Nebulea-dev/FlashDrink/assets/automate_etats.png

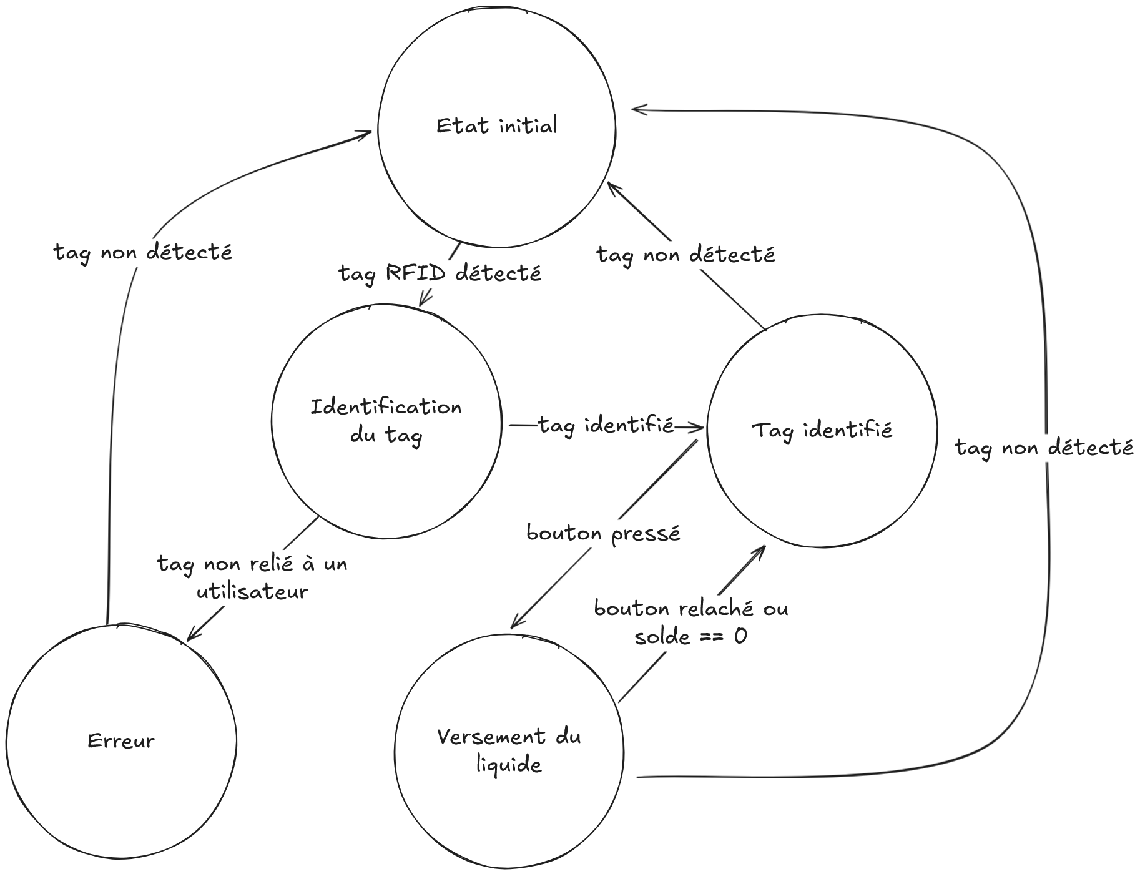
assets/automate_etats.png
