Nebulea-dev/FlashDrink/assets/branchements.png

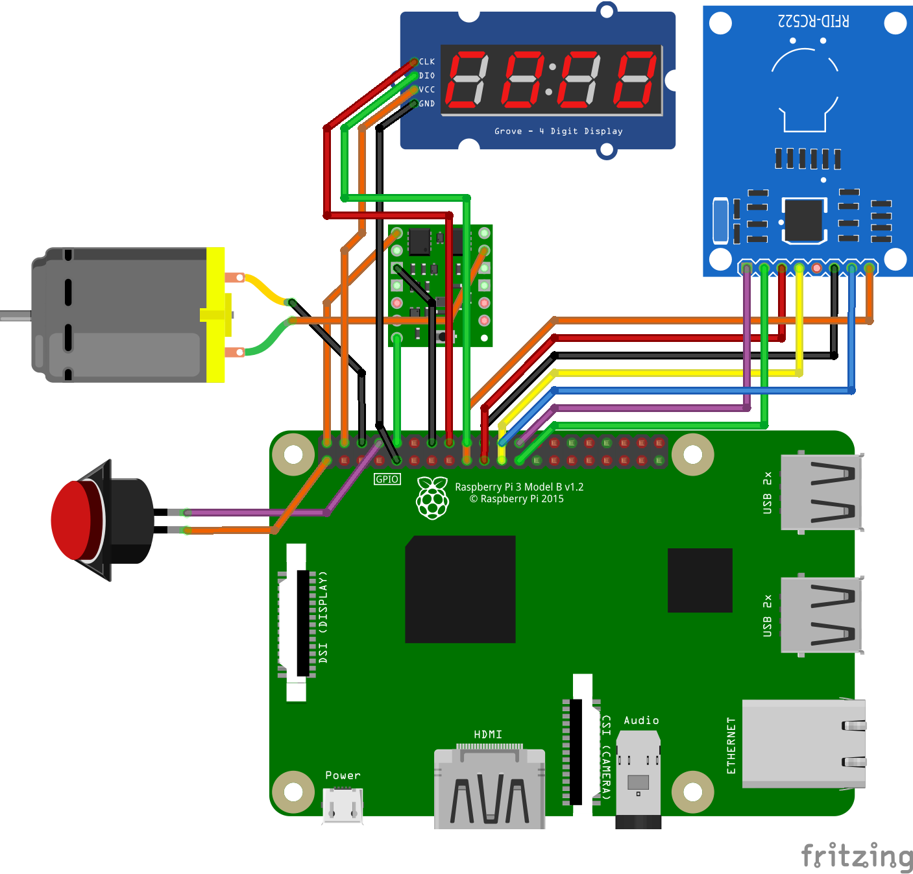
assets/branchements.png
