Nebulea-dev/FlashDrink/assets/vue_ensemble.png

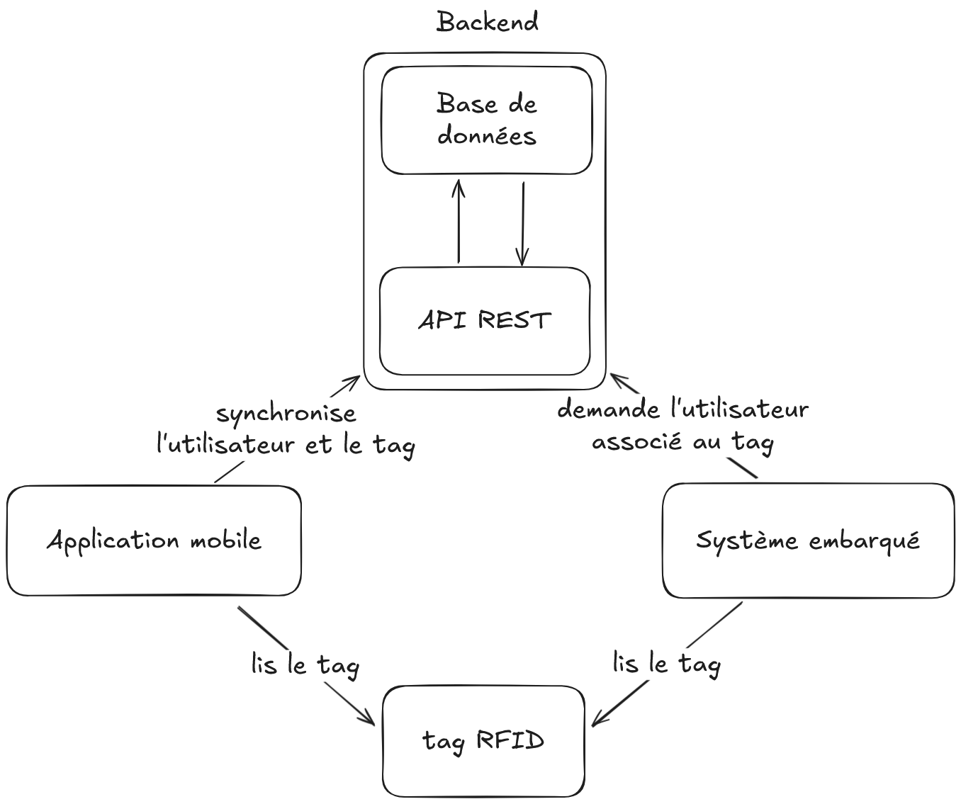
assets/vue_ensemble.png
