Nebulea-dev/FlashDrink/3D-model/flashdrink.stl

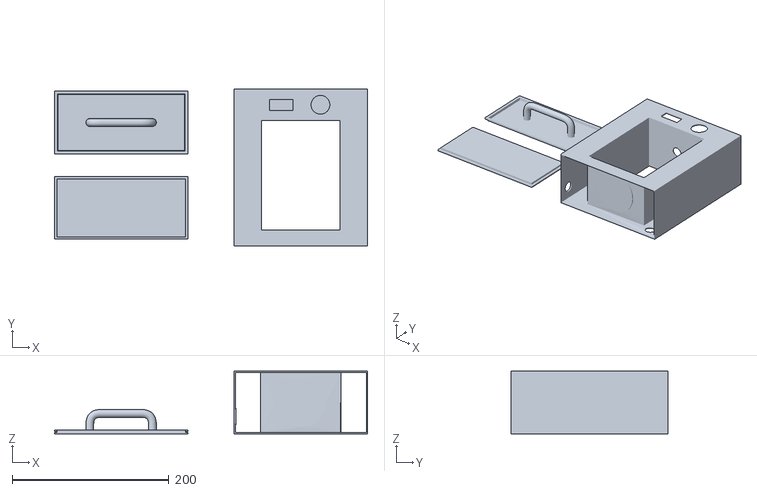
[picture p4: CAD file, 2025-01-14]
3D-model/flashdrink.stl
399.3 x 200.0 x 80.0
