Nebulea-dev/FlashDrink/(list of files, cad)

Other CAD files:
3D-model/flashdrink.blend
