Nebulea-dev/FlashDrink/raspberry/Display.py

import tm1637
class FD_Display:
    tm = tm1637.TM1637(clk=23, dio=24)

    @staticmethod
    def write_number(num: int) -> None:
        FD_Display.tm.number(num)

    @staticmethod
    def write_letters(letters) -> None:
        FD_Display.tm.show(letters)


# all LEDS on "88:88"
#tm.write([127, 255, 127, 127])

# all LEDS off
#tm.write([0, 0, 0, 0])

# show "0123"
#tm.write([63, 6, 91, 79])

# show "COOL"
#tm.write([0b00111001, 0b00111111, 0b00111111, 0b00111000])

# show "HELP"
#tm.show('help')

# display "dEAd", "bEEF"
#tm.hex(0xdead)
#tm.hex(0xbeef)

# show "12:59"
#tm.numbers(12, 59)

# show "-123"
#tm.number(-123)

# show temperature '24*C'
#tm.temperature(24)
