Nebulea-dev/FlashDrink/(commit log)

2024-11-17 Restructure the architecture of the project to a "classic Arduino Project"
2024-11-17 add: update README and add build/upload scripts for Arduino Yùn Mini
2024-11-23 refacto: move arduino code in /arduino + remove .vscode
2024-11-23 feat: add register screen + add balance button in scan screen
2024-11-26 feat: add disconnect button and icons and name change
2025-01-07 feat: add basic raspberry code for all components
2025-01-07 refacto: remove arduino code
2025-01-08 feat: add Button and Pump class
2025-01-14 fix: change mobile-app folder name + add 3D model files
    [flashdrink.blend, flashdrink.stl]
